Kenneract/Bose-Reverse-Engineering/Sources.md

Sources Used

---

- [0] Troubleshooting Guide 321 and 321GS Series II Home Entertainment System (2005, 273029-TG Rev. 00)
	- [Download](https://cdn.discordapp.com/attachments/751294955473076324/997008036289851402/Bose_Source_0.pdf)

---

- [1] Service Manual 321, 321GS and 321GSX Series II Home Entertainment Systems (2012, 273029-SM Rev. 12)
	- [Download](https://cdn.discordapp.com/attachments/751294955473076324/997008036591845396/Bose_Source_1.pdf)

---

- [2] Troubleshooting Guide Lifestyle PS 28 and 48 Digital Acoustimass Powered Speaker (2003, 268795-TS Rev 00 06/03)
	- [Download](https://cdn.discordapp.com/attachments/751294955473076324/997008037011267595/Bose_Source_2.pdf)

---

- [3] AV321 Test Automation Protocol (266861, REV00)
	- [Download](https://cdn.discordapp.com/attachments/751294955473076324/997008037468450896/Bose_Source_3.pdf)

---

- [4] LS28-35 Postman ETAP (Extended Test Access Port) Command Set (8/22/02)
	- [Download](https://cdn.discordapp.com/attachments/751294955473076324/997008037640421448/Bose_Source_4.pdf)

---

- [5] 3-2-1 Home Entertainment System Service Manual Schematics (263493 Rev. 01)
	- [Download](https://cdn.discordapp.com/attachments/751294955473076324/997008037816574042/Bose_Source_5.pdf)

---

- [6] PS321 Bass Module DSP and Amplifier PCB (P/N 279318 Rev. 01)
	- [Download](https://cdn.discordapp.com/attachments/751294955473076324/997008038215036958/Bose_Source_6.pdf)

---
