Kenneract/Bose-Reverse-Engineering/(commit log)

2022-07-12 Quick clarification for peak vs. average voltages
2022-07-14 Add initial KiCad project for replacement unit
    [boseReplacement.kicad_pcb, boseReplacement.sch]
2022-07-14 Add initial firmware for replacement unit
    [Firmware.ino, SmartSpeaker.ino, SoftwareSerialWithHalfDuplex.cpp, SoftwareSerialWithHalfDuplex.h]
